tks24u-boop/Folduo/hardware/claude-clamshell-dock/docs/research.md

# リサーチ：縦置きクラムシェルスタンドの採寸・長所・短所

## 0. 再調査（2026年9月29日）

3版（TŌGE）を作る前に、7つの観点で調べ直しました。観点は、海外の高級品、口コミの不満、国内製品、3Dプリント作例、MacBook Air M5の仕様、素材と印刷、造形の考え方です。1〜5章は最初の調査（9月28日）のままです。

### 不満の多い順（独立した出典の数）

| 順 | 不満 | 出典の数と例 | 3版での対策 |
|---|---|---|---|
| 1 | 倒れる。手が触れる、ケーブルを引っかける、斜めに置くと台ごと倒れる | 約18件。[WIRED](https://www.wired.com/review/twelve-south-bookarc-flex-vertical-laptop-stand/)はBookArc Flexに3/10。[iMore](https://www.imore.com/accessories/twelve-south-bookarc-flex-review)では13インチAirを含む2台とも倒れた。Twelve South自身が猫のいる家には別の型を勧めている | 裾を138 mmに広げ、脚をその先端へ。3.7 Nで脚が浮き始め、4.0 Nで倒れる。ヒンジ下に差してポートを低くし、ケーブルは高さ8 mmで押さえる |
| 2 | 11.3 mmのAirだと緩い、揺れる | 約15件。[Grovemade](https://grovemade.com/product/wood-macbook-dock/)は「M2 Airは薄すぎて遊びが出る」と明記。[BookArc Flex](https://twelvesouth.com.au/products/bookarc-flex)はM2〜M5 Air非対応。調整式の最小幅は14〜16 mm（[MONOQLO](https://360life.shinyusha.co.jp/articles/-/41019)） | 45°のV溝で角を受けて中央に座らせ、上は片側0.3 mmあけたパッドで、上端の揺れを約4 mmに抑える |
| 3 | ケーブルの行き場がない。抜くと机の裏へ落ちる | 約11件。[WIRED](https://www.wired.com/review/twelve-south-bookarc-flex-vertical-laptop-stand/)はFlexがCable Catchをなくしたことを指摘。[TechTwo](https://www.techtwo.tv/reviews/satechi-aluminum-vertical-laptop-stand-review/)、[MacTrast](https://www.mactrast.com/2012/12/review-rain-design-mtower-for-macbooks/) | ポートのある右端の後ろに下から押し込む溝。プラグの頭は溝の穴を通らないので、抜いたプラグは右の端面で止まる |
| 4 | 抜くとドックが一緒に持ち上がる。両手が要る | 約11件。[9to5Mac](https://9to5mac.com/2016/03/07/grovemade-macbook-dock-review/)（Grovemade）、[mTower](https://www.amazon.com/dp/B00A42Y0PA)、[note](https://note.com/clow_luna/n/n5ba2098bfb5e) | 何も挟まない。真上に抜けば、V溝は持ち上げた瞬間に離れる（5°ほど傾けて片手で抜くと、摩擦で浮くことがある） |
| 5 | 傷が付く。入口の硬い角、縁を覆わないパッド、中央の仕切り、砂ぼこり | 約12件（心配の声も含む）。[Chamsaler](https://digimaroblog.com/chamsaler-pc-stand-review/)、[Brydge](https://geardiary.com/2021/07/05/brydge-vertical-dock-review/) | 入口はラッパ形に丸める。触れるのはフェルトだけ。パッドの縁はフェルトより0.5 mm奥 |
| 6 | 熱。ファンレスのAirはクラムシェルで性能が落ちる | 約10件。M3 Airは20分の負荷でふたを閉じると初回の約52%、開けると約73%（[Macworld](https://www.macworld.com/article/2269055/m3-macbook-air-clamshell-display-mode-throttling-performance.html)）。スタンドが原因だという測定はない | 触れる面を最小にし、中央は開ける。冷却効果はうたわない |
| 7 | 安っぽい。プラスチック感、むき出しの縁、ネジ、かさばる | 約10件と、1版への持ち主の評価（太すぎる） | 継ぎ目のない一体の形、端面の断面を見せる、1.5 mmの面取りで統一、継ぎ目は奥に |
| 8 | インサートやライナーがなくなる、外れる、粘着がずれる | 約7件。[mTower](https://talk.macpowerusers.com/t/rain-design-mtower-or-bookarc/28380)のアダプター紛失、[Oakywood](https://oakywood.shop/blogs/news/laptop-dock-stand-updates)は貼るフェルトをネジ留めに変更 | フェルトは縁のあるくぼみに貼る。外れる部品は作らない |
| 9 | 差し込みにコツがいる。まっすぐでないと入らない | 約6件。[Brydge](https://geardiary.com/2021/07/05/brydge-vertical-dock-review/)は3回ほどやり直した | 入口はどこでも31 mm。V溝が中央に導く |
| 10 | 机の上で滑る、貼った脚がはがれる | 約6件。[The Observatory](https://www.printables.com/model/110647-the-observatory-a-parametric-vertical-laptop-stand)は脚なしで滑る | ゴム脚を深さ0.8 mmのくぼみに入れ、横にずれないようにする |

### 手本にしたもの

- **Twelve South BookArc**（158 g、214.8×91.4×55.8 mm）：機種専用のインサートで隙間なく座らせ、脚の間の切り欠き（Cable Catch）でケーブルを受ける。フィットとケーブル受けの大切さ。
- **BookArc Flex**：デザイン賞を取ったが、WIREDは倒れるとして3/10。見た目だけでは製品にならない。
- **Grovemade**：「見た目の量感を減らし、実際は重くした」。空の状態でも美しいこと。
- **Rain Design mTower**（665 g、奥行114 mm）：一体で緩む所がない。計算上この分野で一番倒れにくい。
- **Brydge**：差し込むと自然に位置が決まる案内。
- **MakerWorldの作例**：ロゴを別に平らに刷ってはめ込むと仕上がりが良い（[2574960](https://3dsearch.net/model/apple-macbook-air-vertical-stand-m2-m3-m4-m5-mw2574960)）。PETGで一体・サポートなし（[FlorinV](https://makerworld.com/en/models/783520-vertical-laptop-stand)）。

### 分かった事実

- MacBook Air 13（M5）：1.13×30.41×21.5 cm、1.23 kg。左にMagSafe 3とThunderbolt 4×2（[Apple](https://support.apple.com/en-us/126320)）。ふたを開けたままでも外部ディスプレイを2台使える（[Apple](https://support.apple.com/en-us/122212)）。
- 負荷時の表面温度（ふたを開けた状態、室温21.5 °C）：ヒンジ側が40〜44 °C、手前側が30〜33 °C（[Notebookcheck](https://www.notebookcheck.net/Insane-performance-and-efficiency-without-fans-Apple-MacBook-Air-13-M5-Entry-Review.1242707.0.html)）。
- AppleがMac用に公開している寸法図はMacBook Neoだけで、「金属を当てない」「ポートとアンテナをふさがない」と書かれている（[Apple](https://developer.apple.com/accessories/dimensional-drawings/)）。
- USB-Cの抜き差しには5〜20 Nかかる（[USB-IF](https://usb.org/sites/default/files/USB%20Type-C_Compliance%20Document_Rev_2_1b_June_2021.pdf)）。TB4ケーブルは太さ4.6〜5.0 mm、最小曲げ半径48 mm（[StarTech](https://media.startech.com/cms/pdfs/tblt4mm1m_datasheet.pdf)）。
- 荷重たわみ温度（0.45 MPa）：PLA Basic 57 °C、PLA Glow 55 °C、PETG HF 69 °C、PETG Basic（2026）71 °C（BambuのTDS）。45 °Cでの荷重試験で、PLAは大きく変形し、PETGはほとんど変わらなかった（MyTechFun）。
- PLAとPETGはほとんど接着しない（[Bambu Wiki](https://wiki.bambulab.com/en/filament-acc/filament/h2d-pla-and-petg-mutual-support)）。
- Bambuの蓄光はPLA Glowだけで、緑・黄・ピンク・青・オレンジがある（[Bambu Store](https://jp.store.bambulab.com/products/pla-glow)）。研磨性があり硬化ノズルが要る（P2Sは標準で硬化鋼ノズル）。明るさは厚さ約2 mmまで増え、2時間で約1割になる（[CNC Kitchen](https://www.cnckitchen.com/blog/which-glow-in-the-dark-filament-is-the-best)）。
- フェルトは10%押しつぶすのに6.9〜145 kPaかかる（[SAE規格](https://usfelt.com/sae_felt_specs.html)）。挟む力を2 mmのフェルトに頼ると、軽い台はMacと一緒に持ち上がる。
- 倒れにくさを試す規格：IEC 60335-1は10°の斜面で倒れないこと。

### 調べきれなかったこと

- Amazonの全文レビュー、MakerWorldのコメント、Reddit、価格.comは、JavaScriptが必要だったりブロックされたりして読めなかった。Amazonは「Customers say」の要約と上位のレビューだけを使った。
- Air M5のヒンジ側の角の丸み、ポートの位置、重心は公表されていない。ゲージと実測で確かめる。
- 市販品の倒れにくさの数値は、どれも寸法と重さからの計算で、測定ではない。

調査日は2026年9月28日です。数値はメーカーの公式ページを優先し、無い場合は販売店の仕様欄を使いました。レビューはWIRED、iMore、How-To Geek、MacRumors、9to5Mac、ITmedia、Amazon.co.jpなどです。redditは取得できませんでした。不明な値は「—」としています。

## 1. 市販品（21製品）

| 製品 | 価格の目安 | 長さ×奥行×高さ (mm) | 重さ | 隙間の決め方 | ケーブル保持 | 良い点 | 弱点（レビュー） |
|---|---|---|---|---|---|---|---|
| Twelve South BookArc（インサート式） | $59.99 / ¥9,800 | 214.8×91.4×55.8 | 158 g | 機種別シリコンインサート（I 11.2 / H 15.6 / G 16.8 / F 16.2 mm） | 脚の間の切り欠き「Cable Catch」 | 機種に合わせた隙間のないフィット。ケーブルが落ちない | 新型Mac用インサートが数か月出ない。インサートは別売り（$10 / ¥1,980）。ケース付きだと外れる。跡が付いた報告。16インチでは不安定 |
| Twelve South BookArc Flex | $49.99 / ¥9,800 | 214×93×55 | 240 g | 重みで閉じる自動調整（〜25.4 mm） | なし | インサート不要 | WIRED 3/10。軽く触れただけで15インチAirが倒れる。iMoreでも13インチAir・16インチProが転倒 |
| Rain Design mTower | 約$45 | 250×114×88 | 665 g | 固定スロット＋ゴムアダプター | なし（横から垂れる） | 一体削り出しで剛性が高い | アダプターを失くすと使えない。きつすぎて台ごと持ち上がる |
| OMOTON LD01 | $24〜31 | 150×94×47 | 510〜600 g | 14〜69 mm、底のネジを六角レンチで調整 | なし | 重く安い | 工具が必要。最小14 mmで薄いAirはぐらつく |
| Satechi 縦置きスタンド（単体） | $44.99 | 179.3×98.6×69.9 | 680 g | 11.18〜28.7 mm、ノブ | 穴だけ（保持なし） | 工具不要。Airにも合う | 実質ケーブル管理なし。入手性 |
| Satechi デュアル | $49.99 | 約127×89×56 | 312 g | 固定 12 mm と 19〜20 mm | なし | 小さい | メーカー自身が「縦向きは倒れることがある」と注意。ケース付きは入らない |
| Spigen LD208S4 | $49.99 | 135×110×45 | 427 g | 14〜27 mm、六角ナット | なし | 4スロット | レビュー少 |
| Lamicall LN14 | $10〜20 | — | — | バネで自動（〜35 mm） | なし | 安い | 詳細不明 |
| Nulaxy LS-02（2スロット） | 約$13 | 約180×112×58 | — | 14〜34 mm、底のネジ | なし | 2台置ける | 調整に本体ごと裏返す必要 |
| UGREEN 20471 | ¥2,034 | 150×80×50 | 176〜230 g | 12〜26 mm、底のノブ | 側面の切り欠き | 安い。Amazon.co.jpで売れ筋 | 中央1本ネジが支点になり左右に揺れる。軽く「PCごと倒れる」との要約 |
| UGREEN 60643（2スロット） | ¥2,809 | 150×105×52 | 約300 g | 12〜26 mm、手締めボルト | なし | 中央が空いて通気 | 強く締めると抜くときに台が持ち上がる |
| Grovemade Wood MacBook Dock | $190 | 203×91×95 | 1.0 kg | 固定 19 mm、フェルト | なし | 木とステンレスの質感、重さ | M2以降のAirは薄すぎて揺れる。高価。旧型はきつすぎて両手が必要 |
| Oakywood Laptop Dock | $87 | 180×90×40 | — | 3〜34 mm、六角レンチ | なし | 吸盤脚で片手操作 | 旧型は2台がぐらつく |
| HumanCentric（自動グリップ） | $40.99 | — | — | 挿すと自動調整（〜25.4 mm） | — | ケース対応 | 詳細不明 |
| Brydge Vertical Dock / ProDock | $169〜$399 | — | 〜2.3 kg | 機種別スリーブ（1個$48） | ドック一体（Thunderbolt） | 差すだけで接続 | 高価、機種ロックイン、会社が一度倒産。ユーザーが「STLで配ってほしい」と要望 |
| Henge Docks（縦置きドック） | $60〜120 | — | 約1.4 kg | 機種専用 | 背面にゴム製ケーブル整理 | 一発で接続 | 抜くのに両手、ケーブル高さ合わせが難しい、初代は樹脂が割れた |
| Kensington StudioCaddy | $179.99 | 206.2×151.8×136.2 | 1.5 kg | 固定（約17 mm） | なし（充電台付き） | 重く倒れない | MacBookは実質充電できない（USB-C 20 W）。大きい |
| PULWTOP BD216C（ハブ内蔵） | $99.89 | 150×104.5×116 | 550 g | 〜40.6 mm 自動 | USB-Cハブ一体 | 11ポート | macOSではHDMI 2画面が拡張でなくミラーのみ |
| サンワサプライ PDA-STN90S | ¥4,400 | 135×88×45 | 333 g | 8〜34 mm、六角レンチ | なし | 薄型にも対応 | メーカーが「排気口を塞がないよう注意」 |
| エレコム PCA-LTSV03SV | ¥4,880 | 150×95〜140×47 | 505 g | 15〜65 mm、六角レンチ | なし | 太い機種も可 | 工具が必要、Airは最小15 mmで入らない |
| SODI SMS300 | ¥3,383 | 162×110×88 | 408 g | 重みで閉じる（〜27 mm） | なし | 片手で抜ける重さ | ヒンジ上向きを推奨（冷却・防塵） |

主な出典：[BookArc](https://www.twelvesouth.com/products/bookarc-for-macbook)、[BookArcインサート一覧](https://support.twelvesouth.com/en-US/can-i-use-bookarc-if-i-have-a-case-on-my-macbook-317545)、[BookArc Flex](https://www.twelvesouth.com/products/bookarc-flex)、[WIRED](https://www.wired.com/review/twelve-south-bookarc-flex-vertical-laptop-stand/)、[iMore](https://www.imore.com/accessories/twelve-south-bookarc-flex-review)、[mTower](https://raindesigninc.com/products/mtower)、[MacTrast](https://www.mactrast.com/2012/12/review-rain-design-mtower-for-macbooks/)、[OMOTON](https://omoton.com/products/ld01)、[Macworld](https://www.macworld.com/article/668912/best-laptop-stands-for-apple-macbook-pro-and-macbook-air.html)、[Satechi](https://www.techtwo.tv/reviews/satechi-aluminum-vertical-laptop-stand-review/)、[Satechi デュアルFAQ](https://support.satechi.com/hc/en-us/articles/41209490433819-Product-FAQ-Dual-Vertical-Laptop-Stand-ST-ADVSM)、[Spigen](https://www.spigen.com/products/vertical-laptop-stand-ld208s4)、[UGREEN (Amazon.co.jp)](https://www.amazon.co.jp/dp/B091B4SWR7)、[Grovemade](https://grovemade.com/product/wood-macbook-dock/)、[Oakywood](https://oakywood.shop/products/vertical-laptop-stand)、[Brydge](https://brydge.com/products/brydge-prodock)、[Henge Docks](https://appleinsider.com/articles/14/06/25/review-henge-docks-vertical-docking-station-for-apples-macbook-pro-with-retina-display-)、[StudioCaddy](https://www.theverge.com/2021/7/6/22564752/kensington-studiocaddy-apple-hands-on-price-specs)、[PULWTOP](https://pulwtop.com/products/docking-station-bd216c)、[サンワサプライ](https://www.sanwa.co.jp/product/syohin?code=PDA-STN90S)、[エレコム](https://www.elecom.co.jp/products/PCA-LTSV03SV.html)、[SODI](https://sodigear.com/products/sms300-vertical-laptop-stand)、[SHOPSTAFF比較](https://shopstaff.jp/contents/84xgvD41)。

### 寸法の相場

| 項目 | 観測範囲 | 多い範囲 |
|---|---|---|
| 長さ（MacBookの幅方向） | 127〜250 mm | 135〜180 mm |
| 奥行（倒れる方向） | 78〜152 mm | 88〜112 mm |
| 高さ | 40〜136 mm | 45〜70 mm |
| 重さ | 158〜1,500 g | 300〜700 g |
| 固定スロット | 11.2〜20 mm | 機種の厚み±0.1 mm |
| 調整式の最小幅 | 3〜15 mm | 11〜14 mm（現行Air 11.3 mmより広いものが多い） |

### 不満の多い順（独立した出典の数）

1. 倒れる・ぐらつく（12件以上）。BookArc Flex、UGREENの1本ネジ、軽い台、薄いAirと最小幅の不一致。
2. 機種・厚み・ケースに合わない（10件以上）。インサートの発売遅れと追加費用、固定幅、調整式の最小幅14〜15 mm。
3. ケーブルが保持されず、Macを抜くと机の裏に落ちる（6件以上）。
4. 抜くときに台が一緒に持ち上がる、両手が要る（5件以上）。
5. 排熱と向き（7件以上。多くは理論的な心配）。
6. 傷・跡（6件）。シリコンの跡、中央の仕切りに当たって傷、広げるとシリコンが途切れる。
7. 調整の手間（5件以上）。六角レンチ、締めにくいネジ。
8. ふたが開く・ヒンジへの負担（2件、ただし深刻）。V字スロットでふたが開いた、ヒンジ下向きで数か月後にヒンジが曲がった報告。

## 2. 3Dプリント作例（27件）から分かったこと

人気作の例：[vert · laptop stand](https://www.printables.com/model/997387-vert-laptop-stand)（1,691いいね、6,163DL）、[The Observatory](https://www.printables.com/model/110647-the-observatory-a-parametric-vertical-laptop-stand)（パラメトリック、PETG推奨、MacBookを15 mm浮かせる）、[MakerWorld FlorinV](https://makerworld.com/en/models/783520-vertical-laptop-stand)（★4.9、213件）、[MacBook Pro Stand](https://makerworld.com/en/models/868030-macbook-pro-stand)（PLA 268 g＋TPU 33 g、13.3時間）、[rift](https://www.printables.com/model/1245939-rift-laptop-stand)（隙間インサート交換式）。

- 最大の不満は「合わない」こと。刷ってから拡大縮小したりフェルトを足したりしている。公称値と実物がずれる、ゴム足やリブで厚くなる、Airは14/16インチ用では緩い。
- 素のPLAの底は滑る。対策はゴム足、磁石、重り（鉄球、コンクリート）。
- 傷対策はフェルト、フォーム、コルク、TPUライナー。
- PLAは熱で変形しうるのでPETG/ABSを勧める作者もいる。16インチProの底面は負荷時に約43 °C（[Notebookcheck](https://www.notebookcheck.net/Apple-MacBook-Pro-16-2024-review-Enormous-battery-life-and-better-performance-of-the-M4-Pro.917793.0.html)）。
- スロット部の割れの実例は見つからなかった。厚い壁と4〜6周の外壁で予防するのが定番。
- 縦面に多色ロゴを入れると層ごとに色替えが起き、「200回以上の色替え」になった例がある。**別パーツのバッジを表向きに伏せて刷り、はめ込む**方法が効率・仕上がりとも良い。
- 印刷の知見：TPU 95Aは圧縮永久ひずみが大きい（23 °C・72時間で38%、[BASF TDS](https://move.forward-am.com/hubfs/AES%20Documentation/Flexible%20Filaments/TPU%2095A/TDS/Ultrafuse_TPU-95A_TDS_EN_v1.0.pdf)）。**強い締め付けを長期間TPUに頼らない**。PLAはクリープが最も大きく、クランプ用のばねには向かない（[Dogan 2022](https://www.sv-jme.eu/?ns_articles_pdf=%2Fns_articles%2Ffiles%2Fojs30%2F191%2F63073da9a438a.pdf&id=6869)）。
- 印刷したTPU脚は、市販のウレタン脚ほど滑りにくくない（[Prusa forum](https://forum.prusa3d.com/forum/english-forum-general-discussion-announcements-and-releases/grippy-flex-material/)）。3M バンポンの摩擦係数は0.9〜1.4（[3M TDS](https://multimedia.3m.com/mws/media/117314O/3m-bumpon-protective-products-molded-shapes-colored-and-clear.pdf)）。

## 3. MacBookの寸法（Apple公式仕様）

| 機種 | 厚み | 幅 | 奥行 | 重さ（最大） | 出典 |
|---|---|---|---|---|---|
| MacBook Neo（2026、A18 Pro） | 12.7 mm（図面では脚なし12.75、脚込み14.70） | 297.5 | 206.4 | 1.23 kg | [仕様](https://support.apple.com/en-us/126322)、[寸法図](https://developer.apple.com/download/files/accessories/dimensional-drawings/macbook-neo.pdf) |
| MacBook Air 13（M2〜M5） | 11.3 | 304.1 | 215.0 | 1.24 kg | [M5](https://support.apple.com/en-us/126320) |
| MacBook Air 15（M2〜M5） | 11.5 | 340.4 | 237.6 | 1.51 kg | [M5](https://support.apple.com/en-us/126321) |
| MacBook Air 13（M1、2020） | 4.1〜16.1（くさび形） | 304.1 | 212.4 | 1.29 kg | [M1](https://support.apple.com/en-us/111883) |
| MacBook Pro 13（M1/M2） | 15.6 | 304.1 | 212.4 | 1.4 kg | [M2](https://support.apple.com/en-us/111869) |
| MacBook Pro 14（2021〜2026） | 15.5 | 312.6 | 221.2 | 1.63 kg | [M5 Pro/Max](https://support.apple.com/en-us/126318) |
| MacBook Pro 16（2021〜2026） | 16.8 | 355.7 | 248.1 | 2.2 kg | [M5 Pro/Max](https://support.apple.com/en-us/126319)、[2021](https://support.apple.com/en-us/111901) |

- Appleの厚みはゴム脚を含まない値です（Neoの寸法図で確認。他機種は明記なし）。脚は四隅にあり、長さ180 mmのドックの外側に来ます。
- ポート：Air（M2以降）は左にMagSafeとThunderbolt×2。Pro 14/16は左にMagSafe・Thunderbolt×2・イヤホン、右にSDXC・Thunderbolt・HDMI。Neoは左にUSB-C×2（ヒンジから23 mmと38 mm）。どれもヒンジ寄りです。
- 通気：Pro 14/16は底面の左右から吸気し、**ヒンジ下の背面から排気**します。Wi-Fiアンテナも同じ部分にあります（Appleの修理手順では「Vent/Antenna Module」）。Air・Neoはファンレスです。
- 向き：Appleは縦置きの向きを指示していません。Apple Communityなどでは「Proはヒンジを上に」が多数意見です。NeoのAppleの寸法図には、後端のアンテナ開口とマイク穴を塞がないよう注記があります。
- クラムシェルモードには電源接続と外部キーボード・マウスが必要です（[Apple](https://support.apple.com/en-us/102501)）。

## 4. Bambu Lab P2S

- 造形範囲 256×256×256 mm、ノズル最高300 °C、ベッド最高110 °C、密閉筐体（能動加熱なし）、既定のプレートはテクスチャPEI（[仕様](https://bambulab.com/en/p2s/specs)）。
- AMS 2 Pro（Comboに付属、4色）とAMS HTに対応し、最大20色まで増やせます。AMS liteは使えません（[互換表](https://wiki.bambulab.com/en/ams/manual/multi-model-AMS-compatibility-guide)）。
- **TPU 95AはAMS 2 Proを通せません**。外部スプールから刷ります。AMS対応の「TPU for AMS」はショア68Dで硬すぎます。
- Bambu Studioのプロファイル（2026年9月の公開リポジトリ）では、P2S用の最大体積流量が次の値です。PLA Matte 22 mm³/s、PETG HF 21 mm³/s、TPU 95A 3.6 mm³/s、**TPU 95A HF 12 mm³/s**。

## 5. リサーチから決めた設計要件

最初の版で立てた要件です。2026-09-29の改訂で、2・4・5は見直しました。機種別の本体と貼るフェルトにし、ケーブル溝はなくしています（[設計ノート](design.md)）。

1. 奥行は多くの製品（88〜112 mm）より広くし、脚は滑りにくくする。
2. 機種に合わせる部品は、ユーザーが自分で刷って差し替えられるようにする。現行MacBookすべてと、任意の厚みに対応させる。
3. 締め付けは軽くし、厚みの誤差は部品のしなりで吸収する。TPUの圧縮永久ひずみに頼らない。
4. ケーブルは底面に隠して通し、保持できるようにする。
5. MacBookが触れるのはTPUだけにする。入口は面取りし、スロットは平行にする（V字にしない）。
6. 工具や調整ネジは使わない。
7. ロゴは別部品を表向きに伏せて刷り、はめ込む。
8. P2Sでサポートなしに刷れるようにする。
