tks24u-boop/Folduo/videos/kioxia-debris/assets/fonts/README.md

# Fonts

All fonts are from Google Fonts and licensed under the SIL Open Font License 1.1
(https://openfontlicense.org):

- Dela Gothic One — Copyright The Dela Gothic Project Authors
- Noto Sans JP (Black) — Copyright Google LLC
- Orbitron — Copyright The Orbitron Project Authors
- Share Tech Mono — Copyright Carrois Type Design
