tks24u-boop/Folduo/README.SM-F966Q.md

# Folduo SM-F966Q 実験版

対象候補：Samsung SM-F966Q / SM-F966Z、Android 16（SDK 36）。
ユーザーのSM-F966Q / One UI 8.5ではq1の演出動作まで報告されています。
q3・q4の修正は実機未検証です。
元コード：bunkaich/Folduo c9e5976cf1d5176652fcf0fc984bb5ec86751d29。

## 改修
- 起動UI・画面制御・壁紙補助・明示的実機テストで共通の機種判定を使用。
- Samsungが公開する同時点灯状態・論理画面0/1の既存確認を維持。
- 壁紙statusに内側動画、純正画像素材、変更/復元APIの診断を追加。
- 復元APIまたは純正画像がない場合は壁紙を変更しない。
- 壁紙補助は所有者ユーザー0だけで実行。
- 直接センサーが1500ms途切れた場合、壁紙からの角度取得へ切替可能。
- 解像度0/負値/非有限/10度以上のセンサーを細角度とは扱わない。
- アプリ移動・履歴選択・復帰時の起動失敗を検出。
- 描画・タッチ遮断・ロック/停止時の解除・監視タイマーは維持。

## ビルド
Java 17、Python 3、Android SDKが必要です。
SDK：platforms;android-37.0、build-tools;36.0.0、platform-tools。
JAVA_HOME / ANDROID_HOMEを設定し、次を実行します。

```sh
./gradlew :app:testDebugUnitTest :app:lintRelease :app:assembleRelease
python3 tools/build-wallpaper-helper.py
```

APK：app/build/outputs/apk/release/app-release.apk。
GitHub Actionsの「Folduo Q experimental build」でも生成できます。
実機テストは自動ビルドの単体テストとは別で、まだ実施していません。

## 導入
先に元のREADME.ja.mdを読んでください。
1. Shizukuを起動。元の壁紙画像・設定を手元に保存します。
2. 内側と前面に、元READMEで指定されたSamsung純正壁紙を設定。
3. MacにPython 3とADBを用意し、USBデバッグを許可して端末を1台接続。
4. 壁紙補助ZIPを展開し、その中のwallpaperフォルダで次を実行。

```sh
python3 cover-wallpaper.py status
```

型番/SDK、Inner angle wallpaper、Stock image resource、Exact apply/restore APIを確認。
statusは壁紙設定を変更しません（補助JARは端末の一時フォルダへ転送します）。
この結果だけで演出全体の互換性が確認できるわけではありません。
falseやエラーが出た場合は適用せず、その診断結果を確認してください。

5. 診断が揃った場合のみ次を実行。

```sh
python3 cover-wallpaper.py apply
```

6. APKを入れ、Shizuku接続・重ねて表示・通知を許可。
7. センサー診断後に有効化し、ロック解除したまま一度完全に閉じてから電卓でゆっくり開閉。

## 署名
元作者と同じapplicationIdですが署名は異なります。元作者版を入れている場合は
アプリ内で停止してからアンインストールし、この版を導入してください。
設定や権限は再設定が必要です。アンインストールだけでは壁紙は戻りません。
これはデバッグ鍵で署名したテスト版です。GitHub Actionsの別実行では署名鍵が変わるため、
その場合も上書き不可となり、停止・アンインストール後の再導入が必要です。

## 停止と復旧
アプリ内の停止を押します。操作不能なら端末を再起動し、
Shizukuを起動する前にFolduoの常時有効を止めてください。
壁紙はAndroid設定で選び直せます。既知の純正静止壁紙に戻す場合は次を使用できます。

```sh
python3 cover-wallpaper.py restore-stock
```

## 未確認事項
- Samsungの完全な壁紙API署名は実機未確認。不一致の場合は変更を拒否します。
- ベンダーセンサー65686の解像度0は、細かな値を出せても粗いセンサーとして扱います。
  Q版のメタデータ確認までは純正壁紙による角度取得が必要です。
- Q版での両画面同時点灯、連続角度、画面転送、ホーム/戻る/履歴、回転、
  ロック、Shizuku停止、再起動、壁紙復元、長時間の電池消費は実機確認が必要です。

## 壁紙補助 q2（実機ログに基づく修正）
- 004番のFoldInteractiveから細角度が返ることをユーザー端末ログで確認。
  q2補助の適用成功と、その後の演出動作はユーザーから報告済みです。
- 002番に加え、video_004.mp4 と sub_wallpaper_004 の組を明示対応。
- 内側と外側が同じ組の純正壁紙である場合だけ適用。任意壁紙は上書きしません。
- 純正URIの拡張子なし／.pngの両形式を認識。復元は現在の外側動画と同じ番号。
- statusに実際の動画名・コンポーネント・外側URIを表示。
- APKの入れ直しは不要。別成果物 Folduo-wallpaper-helper-q2 を展開し、
  そのwallpaper/cover-wallpaper.pyでstatusを実行、対応確認後applyを実行します。
- Folduoは停止してから適用。非表示の壁紙ログを有効角度として採用する変更はしません。

## アプリ q3（One UIホームとの連携・開閉処理）
- 設定中のホームアプリを開閉時・ホームボタン・停止時の復帰で参照。
  選択中のホームが見つからないとき、残っている別のホームへ勝手に切り替えません。
- APIの成功コードだけでなく、対象タスクが指定画面へ移ったことを確認。
  履歴順が更新中でも、実際に選んだタスクへフォーカスします。
- 転送先の描画はタスクIDとサイズが2回続けて一致した場合のみ完了扱い。
  同じサイズの古いホーム画面を、移動したアプリと誤認しません。
- 転送途中の反転は最新の方向を保留し、進行中の転送が完了してから処理。
- 開ききった位置と閉じきった位置の待ち時間を別に判定。
  壁紙角度が停止しても、古い値の繰り返しで完了を捏造しません。
- 開閉中に回転・サイズ変更が起きた場合は画像を引き延ばさず通常表示へ戻す。
- 開閉前にキューに入ったナビ操作の遅延実行を防止。復帰時は1タスクが失敗しても残りを処理。
- CIはJVMテスト・release lint・APKビルドに加え、API 36のエミュレーターで
  TaskDisplayRouterTestを実行。タスク管理APIはテスト用の応答であり、
  Samsungの非公開API、One UI画面、ヒンジ、両画面ハードウェアの実機検証ではありません。

### q1からq3へ
1. Folduo内で「停止」を押す。ホームはOne UIホームを選択したままで構いません。
2. 別CIビルドの署名鍵が異なるため、旧Folduoをアンインストールしてq3 APKを導入。
   Folduo内の配置・設定・権限は消えるので、必要な設定を先に控えてください。
   Samsungの壁紙設定はそのままです。q2壁紙補助を適用し直す必要はありません。
3. Shizuku接続・重ねて表示・通知を再許可し、有効化。
4. ロック解除したまま一度完全に閉じ、One UIホームからゆっくり開閉。
   次に電卓、途中反転、ロック解除、停止時の復帰を確認します。

### 残るOne UIの制約
現方式は両画面を同時点灯させ、内側を補助ディスプレイとして扱います。
元実装にある「内側の純正ジェスチャー／通知パネルが完全には使えない」こと、
「内側の他社ホームからの新規アプリ起動が前面へ回され得る」ことをq3で解消したとは言えません。
普段どおりのOne UI操作を優先する場合はFolduoの停止で通常の画面制御へ戻せます。
今回修正した誤転送・競合・描画待ちの不具合と、この構造上の制約は区別してください。

## アプリ q4（操作画面・応答性）
- 開始／停止と現在の状態を先頭に配置。初期設定・使い方・診断を折りたたみ、開閉状態を画面再生成時も保持。
- One UIホームを使う人向けに、独自ホームの設定を任意の項目へ分離。日本語／英語、前面／内側の幅に対応。
- 設定画面の状態更新を表示中だけ、最大1秒ごとに制限。同じ表示内容の再設定を省略。
- 独自ホームはアプリ一覧とアイコンを保持し、パッケージ変更・表示密度変更時に更新。起動処理は一覧読み込みと別のキューで実行。
- アプリ一覧の行を再利用し、検索用ラベルを保持。時計は分単位、電池は変更通知で更新。
- 内側操作バーは「戻る」「ホーム」のたびにウィンドウを作り直さず、タップ領域を48dpへ拡大。
- 履歴サムネイルは1枚ずつ取得し、その間に入った操作を先に処理。閉じた／切り替えた履歴への古い応答を破棄。
- 壁紙への角度問い合わせは開閉中16ms、待機中33ms、対象ウィンドウがない間250msの間隔。通常の開閉中の描画速度とぼかし品質は変更しない。
- 中止したぼかし生成の未公開ビットマップを破棄。表示中の画像・呼び出し元の画像はリサイクルしない。
- CIで一覧保持・画面を離れた後のタイマー停止・連続ナビ操作・中断・日本語の2画面幅を検証。
  応答待ちはテスト用Binderで再現する。実機でのフレームレート・消費電力・体感改善は未計測。

### q4への更新
上の「q1からq3へ」と同じ手順で、APKだけq4を使用してください。
旧版を停止してアンインストール後、q4を導入し、権限を再設定します。
q2壁紙補助の再適用は不要です。One UIの構造上の制約はq4にも残ります。
