tks24u-boop/Folduo/hardware/claude-clamshell-dock/print/1_body_PETG.3mf

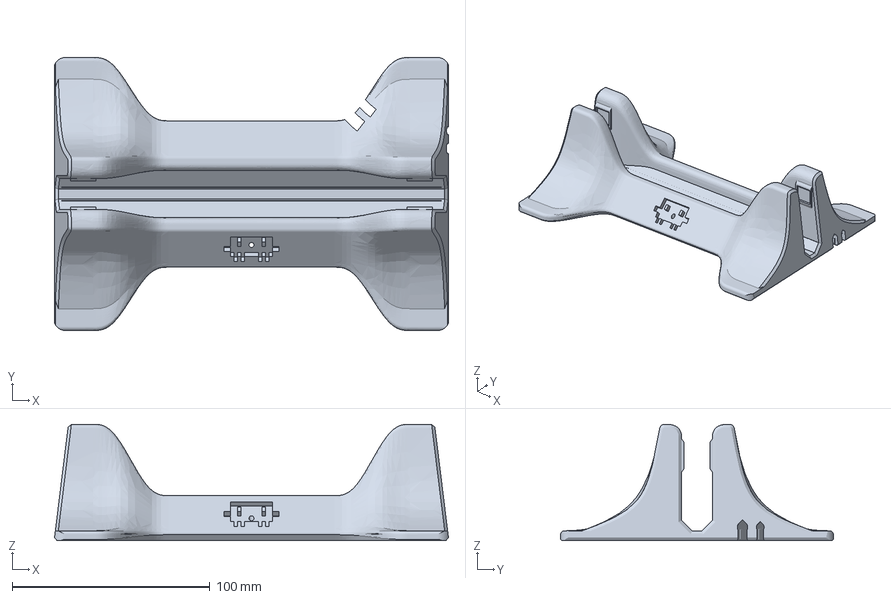
[picture p8: CAD file, 2026-09-29]
hardware/claude-clamshell-dock/print/1_body_PETG.3mf
199.1 x 138.0 x 58.8 mm
