tks24u-boop/Folduo/hardware/claude-clamshell-dock/print/0_fit_gauge_PETG.3mf

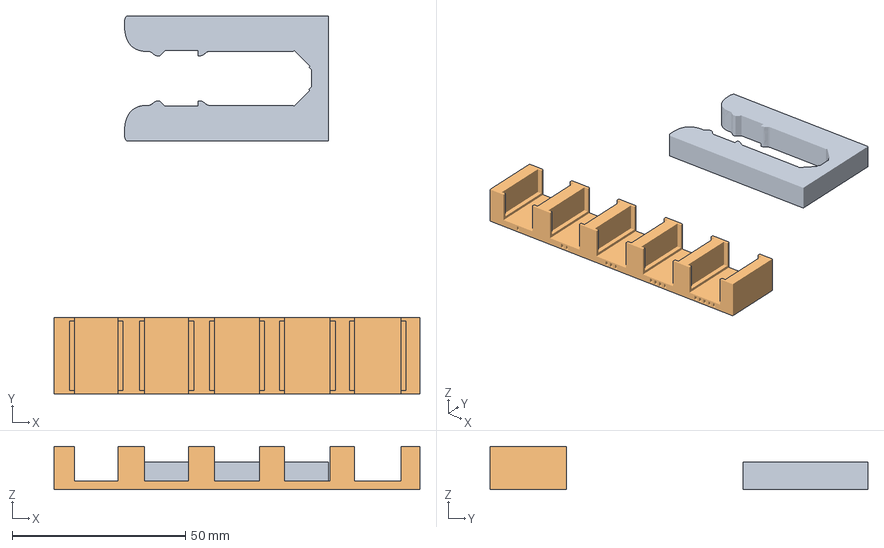
[picture p9: CAD file, 2026-09-29]
hardware/claude-clamshell-dock/print/0_fit_gauge_PETG.3mf
105.5 x 109.0 x 12.5 mm
gauge_slice
gauge_comb
