tks24u-boop/Folduo/hardware/claude-clamshell-dock/print/2_clawd_badge.3mf

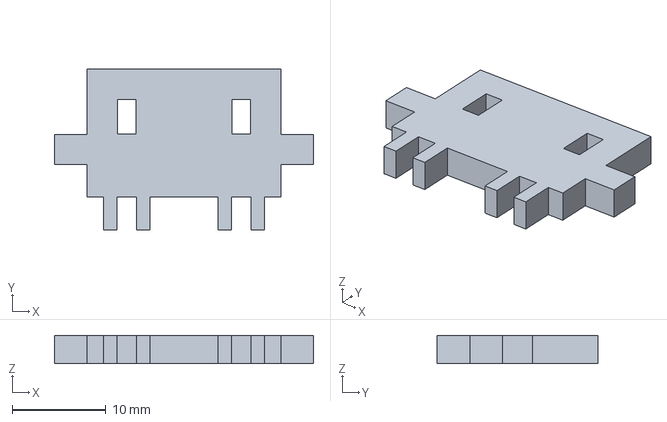
[picture p10: CAD file, 2026-09-29]
hardware/claude-clamshell-dock/print/2_clawd_badge.3mf
27.7 x 17.2 x 3.00 mm
