tks24u-boop/Folduo/(commit log)

2026-09-16 Stabilize default-home routing and fold handoffs for Q build
    Keep the selected launcher, confirm task arrival and matching drawn frames, serialize reversals, and reset endpoint dwell per side. Cancel invalid snapshots after rotation and stale navigation callbacks.
    Add regression tests and Android emulator router checks. Bump the experimental APK to q3; retain q2 wallpaper setup and document remaining One UI limitations.
2026-09-28 Add Three.js offline video renderer for the KIOXIA SHOCK short
    Deterministic frame renderer (headless Chromium + SwiftShader), extruded
    Japanese 3D text, bloom/glitch/HUD post chain, parallel H.264 render
    pipeline, storyboard and beat-synced cue timeline.
    Claude-Session: https://claude.ai/code/session_01WMj9ffVHZoxmcUCGhnHHXB
2026-09-28 Render in delivery-encoded chunks that can be joined losslessly
    Adds tools/concat.mjs and tools/cloud_render.sh so frame ranges can be
    rendered on separate containers and muxed with the BGM afterwards.
    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
2026-09-28 Add Claude Code clamshell dock for Bambu Lab P2S
    A 3D-printable vertical dock for MacBooks in clamshell mode, with the
    Claude Code mascot (Clawd) inlaid in the front face.
    - Parametric build123d model (src/clamshell_dock.py) that writes STL,
    STEP and ready-to-open 3MF files for a Bambu Lab P2S (256 mm cube).
    - Body: 200 x 116 x 46 mm, prints upright without supports; T-shaped
    cable channel with a 45-degree ridge roof, pockets for bumper feet,
    snap pegs for the liners.
    - TPU liners with 1.2 mm membranes over a 0.8 mm air gap, one pair per
    MacBook family (Neo, Air M2-M5, M1 Air wedge, Pro 13/14/16), plus a
    --liner option for any thickness.
    - Clawd logo taken from the Claude Code CLI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
    [1_body_PLA.3mf, 1b_body_no_logo_PLA.3mf, 2_logo_clawd_2color_AMS.3mf, 2b_logo_clawd_single_color.3mf, 3_TPU_liners_air_feet_grommets.3mf, 3_TPU_liners_m1air_feet_grommets.3mf, 3_TPU_liners_neo_feet_grommets.3mf, 3_TPU_liners_pro14_feet_grommets.3mf]
2026-09-28 Add liner fit-test coupons and balance liner squeeze
    - 16 mm test slices of every liner (one bump per side, no snap holes)
    in print/3mf/0_TPU_fit_test_all_liners.3mf, so the fit can be felt on
    the real Mac before printing the full pair.
    - Tune the Air liner for 11.45 mm and the M1 Air liner for 16.05 mm so
    no model is squeezed more than 0.125 mm per side.
    - Japanese labels on the dimension drawing; README points to the
    coupons first.
    Claude-Session: https://claude.ai/code/session_019LJWfto34kRLn6c8oPEaaM
    [0_TPU_fit_test_all_liners.3mf, 1_body_PLA.3mf, 1b_body_no_logo_PLA.3mf, 2_logo_clawd_2color_AMS.3mf, 2b_logo_clawd_single_color.3mf, 3_TPU_liners_air_feet_grommets.3mf, 3_TPU_liners_m1air_feet_grommets.3mf, 3_TPU_liners_neo_feet_grommets.3mf]
2026-09-28 Write 3MF files deterministically
    Use a fixed relationship id and fixed zip timestamps so regenerating the
    print files does not change them unless the geometry changes.
    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
    [0_TPU_fit_test_all_liners.3mf, 1_body_PLA.3mf, 1b_body_no_logo_PLA.3mf, 2_logo_clawd_2color_AMS.3mf, 2b_logo_clawd_single_color.3mf, 3_TPU_liners_air_feet_grommets.3mf, 3_TPU_liners_m1air_feet_grommets.3mf, 3_TPU_liners_neo_feet_grommets.3mf]
2026-09-28 Add product renders of the clamshell dock
    Six Cycles renders (assembled with a MacBook Pro 14, dock only, logo
    close-up, exploded view, underside, charcoal colour variant) produced by
    src/render_blender.py and referenced from the README.
    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
2026-09-29 Slim the clamshell dock down and line it with felt
    Rework the dock for the MacBook Air 13 (M5) after feedback that the first
    version had too many files, was too bulky and had not really considered heat.
    - The body is now a thin, wide base plate with a slim upright: 180x104x34 mm,
    95 g of PLA and about 2 h (was 200x116x46 mm, 252 g, 4 h). Measured the
    same way (pivot on the feet), the tipping margin is unchanged.
    - The slot is sized for the Air (15.6 mm) and lined with 2 mm self-adhesive
    felt. This replaces the five printed TPU liner sets, the test coupons, the
    TPU feet and the cable grommets.
    - Only two print files remain (body and logo). The STL, STEP and variant
    files are gone;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
    [0_TPU_fit_test_all_liners.3mf, 1_body_PLA.3mf, 1b_body_no_logo_PLA.3mf, 2_logo_clawd.3mf, 2_logo_clawd_2color_AMS.3mf, 2b_logo_clawd_single_color.3mf, 3_TPU_liners_air_feet_grommets.3mf, 3_TPU_liners_m1air_feet_grommets.3mf]
2026-09-29 Rebuild the dock as TOGE: a PETG mountain-pass body with a glow Clawd
    After re-researching competitor reviews and 3D-printed stands, the top
    complaints were tipping, a loose fit on the 11.3 mm Air and cables falling
    behind the desk. v3 answers them in one black PETG body:
    - A low 24 mm middle and two 66 mm Fuji-section peaks, lofted from one
    22-edge section family on a single smootherstep, so it reads as one form.
    - Four feet at the skirt tips give a 66.5 mm pivot: 4.2 N at the Mac's top
    edge and 33 deg to tip, on filament alone (v2: 2.9 N, 25 deg).
    - The Mac stands hinge-down on the corner rounds in a felt-lined 45 deg V;
    four felt pads at the peaks sit 0.3 mm off each face, so nothi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
    [0_fit_gauge_PETG.3mf, 1_body_PETG.3mf, 1_body_PLA.3mf, 2_clawd_badge.3mf, 2_logo_clawd.3mf]
2026-09-29 Fix the review findings in the TOGE dock model and checks
    - Pad lands grow from gap-based relief walls with tangent ramps, the lower
    one never steeper than 45 deg; felt pockets get a 45 deg ceiling
    - Clearances for the Clawd badge move into the badge itself, so a tight
    or loose badge is a five-minute reprint instead of a new body
    - Cable channels move inboard, clear of the toe tip; a push-out hole
    that fully opens into the seal pocket
    - Fit gauge cut down to a horn slice and a working five-slot comb
    - 3MF files carry Bambu Studio per-object settings (walls, infill,
    back seams; 100 % infill and a filament per part for the badge)
    - check_fit takes the same fit options as the model and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
    [0_fit_gauge_PETG.3mf, 1_body_PETG.3mf, 2_clawd_badge.3mf]
2026-09-29 Refine TOGE after the stability and design reviews
    - Peaks lowered to 60 mm and the end faces leaned 7 deg inward, so each
    peak tapers; the pad lands, V felt and gauge slice follow
    - A 19-station loft keeps the skin within 0.01 mm of the section law;
    check_fit now measures it (the old loft sagged 0.4 mm past x = 42)
    - The V sits 1.5 mm higher on a 4.9 mm web: the Mac's weight now closes
    the pad gaps by about 0.05 mm a side, and the lands are set out by that
    - Stability reports when the far feet lift (foot centres) as well as when
    the dock falls (foot edges), minus the Mac's lean in its pad gap
    - Cable channels and plug docks only at the port end, moved inboard; where
    the rear skirt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
    [0_fit_gauge_PETG.3mf, 1_body_PETG.3mf, 2_clawd_badge.3mf]
2026-09-29 Document the refined TOGE: numbers, felt and glow colours, new images
    - README and design notes carry the new geometry and the honest
    stability numbers (far feet lift at 3.7 N, the dock falls at 4.0 N),
    the web stiffening, the cable gates and the right-end-only cable
    features, 0.16 mm layers and back seams, black felt and orange glow
    - The owner's tests now read the lift-off value (370 g) and add a
    5 deg off-vertical lift; undock by pressing the toes, not the peaks
    - New hero render with a Silver Mac, a seated-eye view, and the
    dimension drawing from the assembly's parameters
    Claude-Session: https://claude.ai/code/session_019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
2026-09-29 Start the pad-land ramps inside the relief wall
    A ramp ending exactly on the wall left a knife-edge contact at the
    land's start that meshed with non-manifold edges for --v-offset 0.7.
    Starting both ramps 0.05 mm inside the wall keeps every fit option
    watertight.
    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
    [0_fit_gauge_PETG.3mf, 1_body_PETG.3mf]
2026-09-29 Rework the cable channels and the owner's guide after the usability review
    - Channels are sized from the measured cable diameters (--usb-od,
    --mag-od): a throat 0.3 mm wider than the cable with two 4 mm teeth
    that it clicks past, instead of a throat squeezing it end to end
    - The 2 mm plug docks are gone: a plugged cable needs 15-20 cm out of
    the end face, so parking meant pulling it back every time. The plug
    head cannot pass the bore, so an unplugged cable stops at the end face
    - The docs no longer claim the channel anchors a plugged cable; the dock
    slides before it tips because the ports sit low
    - README reordered to gauge, body, badge, assembly; a levelled paper
    test for the sl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
    [1_body_PETG.3mf]
2026-09-29 Replace the product images with full-quality renders of the final dock
    Hero, seated view, dock, left end, rear and night shots at 1600 x 1067,
    with a Silver Mac and the right end's clean cable channels.
    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
